nightswimmer/RaspberryPiPicoBase/docs/reference/RPI-RP2350A-MINIMAL_R4-S1_BOM.md

# Reference BOM: RPI-RP2350A-MINIMAL R4-S1

Bill of materials of the Raspberry Pi RP2350A minimal design example (revision R4-S1, July 2026) that this project is based on.
Source: Raspberry Pi Ltd, MIT licence, see NOTICE.md. Kept as a reference for part values and part numbers.

| Item | QTY | Refs | Value | Manufacturer | Manufacturer-PN | RPI-PDB-PN | Description |
|---|---|---|---|---|---|---|---|
| 1 | 3 | C1,C5,C19 | 10u | Murata | GRM21BR61C106KE15L | RP-01GYSK-AVBE41 | Capacitor, MLCC, 10uF, 10%, M2012, 16V, X5R |
| 2 | 11 | C2,C8,C10,C11,C12,C13,C14,C15,C16,C17,C18 | 100n | Murata | GRM155R71E104KE14D | RP-01BJ9Y-KRGF41 | Capacitor, MLCC, 100nF, 10%, M1005, 25V, X7R (10k Reel) |
| 3 | 2 | C3,C4 | 15p | Murata | GRM1555C1H150JA01D | RP-01C89W-LLY9XV | Capacitor, MLCC, 15pF, 5%, M1005, 50V, C0G |
| 4 | 3 | C6,C7,C9 | 4.7u | Murata | GRM155R60J475ME47D | RP-019A1P-0C2GHY | Capacitor, MLCC, 4.7uF, 20%, M1005, 6.3V, X5R (10k Reel) |
| 5 | 1 | J1 | 10103594-0001LF | Amphenol | 10103594-0001LF | RP-019A1P-1JAX7V | Micro-USB B, Socket, RA, PTH/SMT |
| 6 | 2 | J2,J3 | TSW-118-07-L-D | Samtec | TSW-118-07-L-D | RP-01JWH2-G371Y4 | Pin Header, 02x18W, 2.54mm, PTH, Male |
| 7 | 1 | J4 | SM03B-SRSS-TB(LF)(SN) | JST | SM03B-SRSS-TB(LF)(SN) | RP-01EKJ1-8V9SV1 | Header, JST-SH, 01x03W, Pitch=1mm, SMD, Right Angle |
| 8 | 1 | L1 | 3.3u | Abracon | AOTA-B201610S3R3-101-T | RP-01GY5D-2VC7WP | Inductor, SMT, 3.3uH, 20%, Itemp=2.1A, Isat=2.4A, DCR=115mR typ 140mR max, Polarity Marked, M2016 |
| 9 | 1 | R1 | NO-FIT |  | NO-FIT |  |  |
| 10 | 3 | R2,R4,R6 | 1k | Yageo | RC0402FR-071KL | RP-019A1P-4Z6ZWY | Resistor, Chip, 1kR, M1005, 63mW, 1% (10k Reel) |
| 11 | 1 | R3 | 33 | Yageo | RC0402FR-0733RL | RP-019A1P-58PW9L | Resistor, Chip, 33R, M1005, 63mW, 1% (10k Reel) |
| 12 | 2 | R7,R8 | 27 | Yageo | RC0402FR-0727RL | RP-01C89V-LTEYC4 | Resistor, Chip, 27R, M1005, 63mW, 1% (10k Reel) |
| 13 | 1 | R9 | NO-FIT |  | NO-FIT |  |  |
| 14 | 1 | R10 | 0 | Yageo | RC0402JR-070RL | RP-019A1P-4Y4V63 | Resistor, Chip, 0R, M1005, 63mW, +50mR |
| 15 | 2 | SW1,SW2 | 434133025816 | Wurth Elektronik | 434133025816 | RP-01H0MT-6E9H8F | Tactile Pushbutton, SPST, N.O., 4.2x3.2x2.5mm |
| 16 | 1 | U1 | RP2350A | Raspberry Pi | RP2350A | RP-01HA9H-9K5E8T | RP2350A MCU, Dual Cortex M33/Hazard3, QFN-60 |
| 17 | 1 | U2 | NCP1117ST33T3G | ON Semiconductor | NCP1117ST33T3G | RP-01JWD9-7JRX6J | LDO, Vin=4.75-20V, Vout=3.3V, 1A min, SOT-223 |
| 18 | 1 | U3 | W25Q128JVSIQ | Winbond | W25Q128JVSIQ | RP-01JWD4-F1H4N9 | Serial NOR Flash, QSPI, 3V, 128Mbit, SOIC-8 |
| 19 | 1 | X1 | 12MHz | Abracon | ABM8-272-T3 | RP-01G8X7-GS352B | XTAL, SMT, 12 MHz, Fundamental, Ftol=30ppm, Fstab=30ppm, 10pF, 3.2x2.5mm |
