nightswimmer/RaspberryPiPicoBase/bom/bom.csv

Designator | Quantity | Value | Footprint | Manufacturer | Manufacturer Part | LCSC Part # | Description
C1,C5,C19 | 3 | 10u | RaspberryPiPicoBase:generic_capc2012x125 | Samsung Electro-Mechanics | CL21A106KAYNNNE | C15850 | Capacitor, MLCC, 10uF, 10%, M2012, 25V, X5R
C3,C4 | 2 | 33p | RaspberryPiPicoBase:generic_capc1005x50 | FH (Guangdong Fenghua Advanced Tech) | 0402CG330J500NT | C1562 | Capacitor, MLCC, 33pF, 5%, M1005, 50V, C0G
C6,C7 | 2 | 4.7u | RaspberryPiPicoBase:generic_capc1005x50_wide | Samsung Electro-Mechanics | CL05A475MP5NRNC | C23733 | Capacitor, MLCC, 4.7uF, 20%, M1005, 10V, X5R
C8,C10-C18 | 10 | 100n | RaspberryPiPicoBase:generic_capc1005x50 | Samsung Electro-Mechanics | CL05B104KO5NNNC | C1525 | Capacitor, MLCC, 100nF, 10%, M1005, 16V, X7R
C9 | 1 | 4.7u | RaspberryPiPicoBase:generic_capc1005x50 | Samsung Electro-Mechanics | CL05A475MP5NRNC | C23733 | Capacitor, MLCC, 4.7uF, 20%, M1005, 10V, X5R
J1 | 1 | TYPE-C-31-M-12 | RaspberryPiPicoBase:USB_C_Receptacle_HRO_TYPE-C-31-M-12 | Korean Hroparts Elec | TYPE-C-31-M-12 | C165948 | USB-C Receptacle, USB 2.0, 16P, SMD, Right Angle, Korean Hroparts TYPE-C-31-M-12
J2,J3 | 2 | DS1021-2x18SF11-B | RaspberryPiPicoBase:samtec_tsw-118-07-l-d | CONNFLY Elec | DS1021-2x18SF11-B | C7430414 | Pin Header, 02x18W, 2.54mm, PTH, Male
L1 | 1 | 3.3u | RaspberryPiPicoBase:abracon_aota-b201610s3r3-101-t | Abracon | AOTA-B201610S3R3-101-T | C42411119 | Inductor, SMT, 3.3uH, 20%, Irms=2.1A, Isat=2.4A, DCR=115mR typ 140mR max, Polarity Marked, M2016
R2,R4,R6 | 3 | 1k | RaspberryPiPicoBase:generic_resc1005x35 | UNI-ROYAL (Uniroyal Elec) | 0402WGF1001TCE | C11702 | Resistor, Chip, 1kR, M1005, 63mW, 1%
R3 | 1 | 33 | RaspberryPiPicoBase:generic_resc1005x35 | UNI-ROYAL (Uniroyal Elec) | 0402WGF330JTCE | C25105 | Resistor, Chip, 33R, M1005, 63mW, 1%
R7,R8 | 2 | 27 | RaspberryPiPicoBase:generic_resc1005x35 | UNI-ROYAL (Uniroyal Elec) | 0402WGF270JTCE | C25100 | Resistor, Chip, 27R, M1005, 63mW, 1%
R11,R12 | 2 | 5.1k | RaspberryPiPicoBase:generic_resc1005x35 | UNI-ROYAL (Uniroyal Elec) | 0402WGF5101TCE | C25905 | Resistor, Chip, 5.1kR, M1005, 63mW, 1%
SW1,SW2 | 2 | TS-1187A-B-A-B | RaspberryPiPicoBase:xkb_ts-1187a-b-a-b | XKB Connection | TS-1187A-B-A-B | C318884 | Tactile Pushbutton, SPST, N.O., 5.1x5.1x1.5mm, 160gf
U1 | 1 | RP2354A | RaspberryPiPicoBase:rpi_rp2350a_vias | Raspberry Pi | RP2354A | C41378174 | RP2354A MCU, Dual Cortex M33/Hazard3, 2 MB internal flash, QFN-60
U2 | 1 | AMS1117-3.3 | RaspberryPiPicoBase:onsemi_ncp1117st33t3g | Advanced Monolithic Systems | AMS1117-3.3 | C6186 | LDO, Vin=4.75-15V, Vout=3.3V, 1A, SOT-223
X1 | 1 | 12MHz | RaspberryPiPicoBase:generic_xtalcc320x250x80-4 | YXC Crystal Oscillators | X322512MSB4SI | C9002 | XTAL, SMT, 12 MHz, Fundamental, Ftol=10ppm, Fstab=20ppm, 20pF, ESR 80R max, 3.2x2.5mm
