nightswimmer/RaspberryPiPicoBase/RaspberryPiPicoBase.kicad_pcb

## KiCad design RaspberryPiPicoBase.kicad_pcb (2026-11-01)

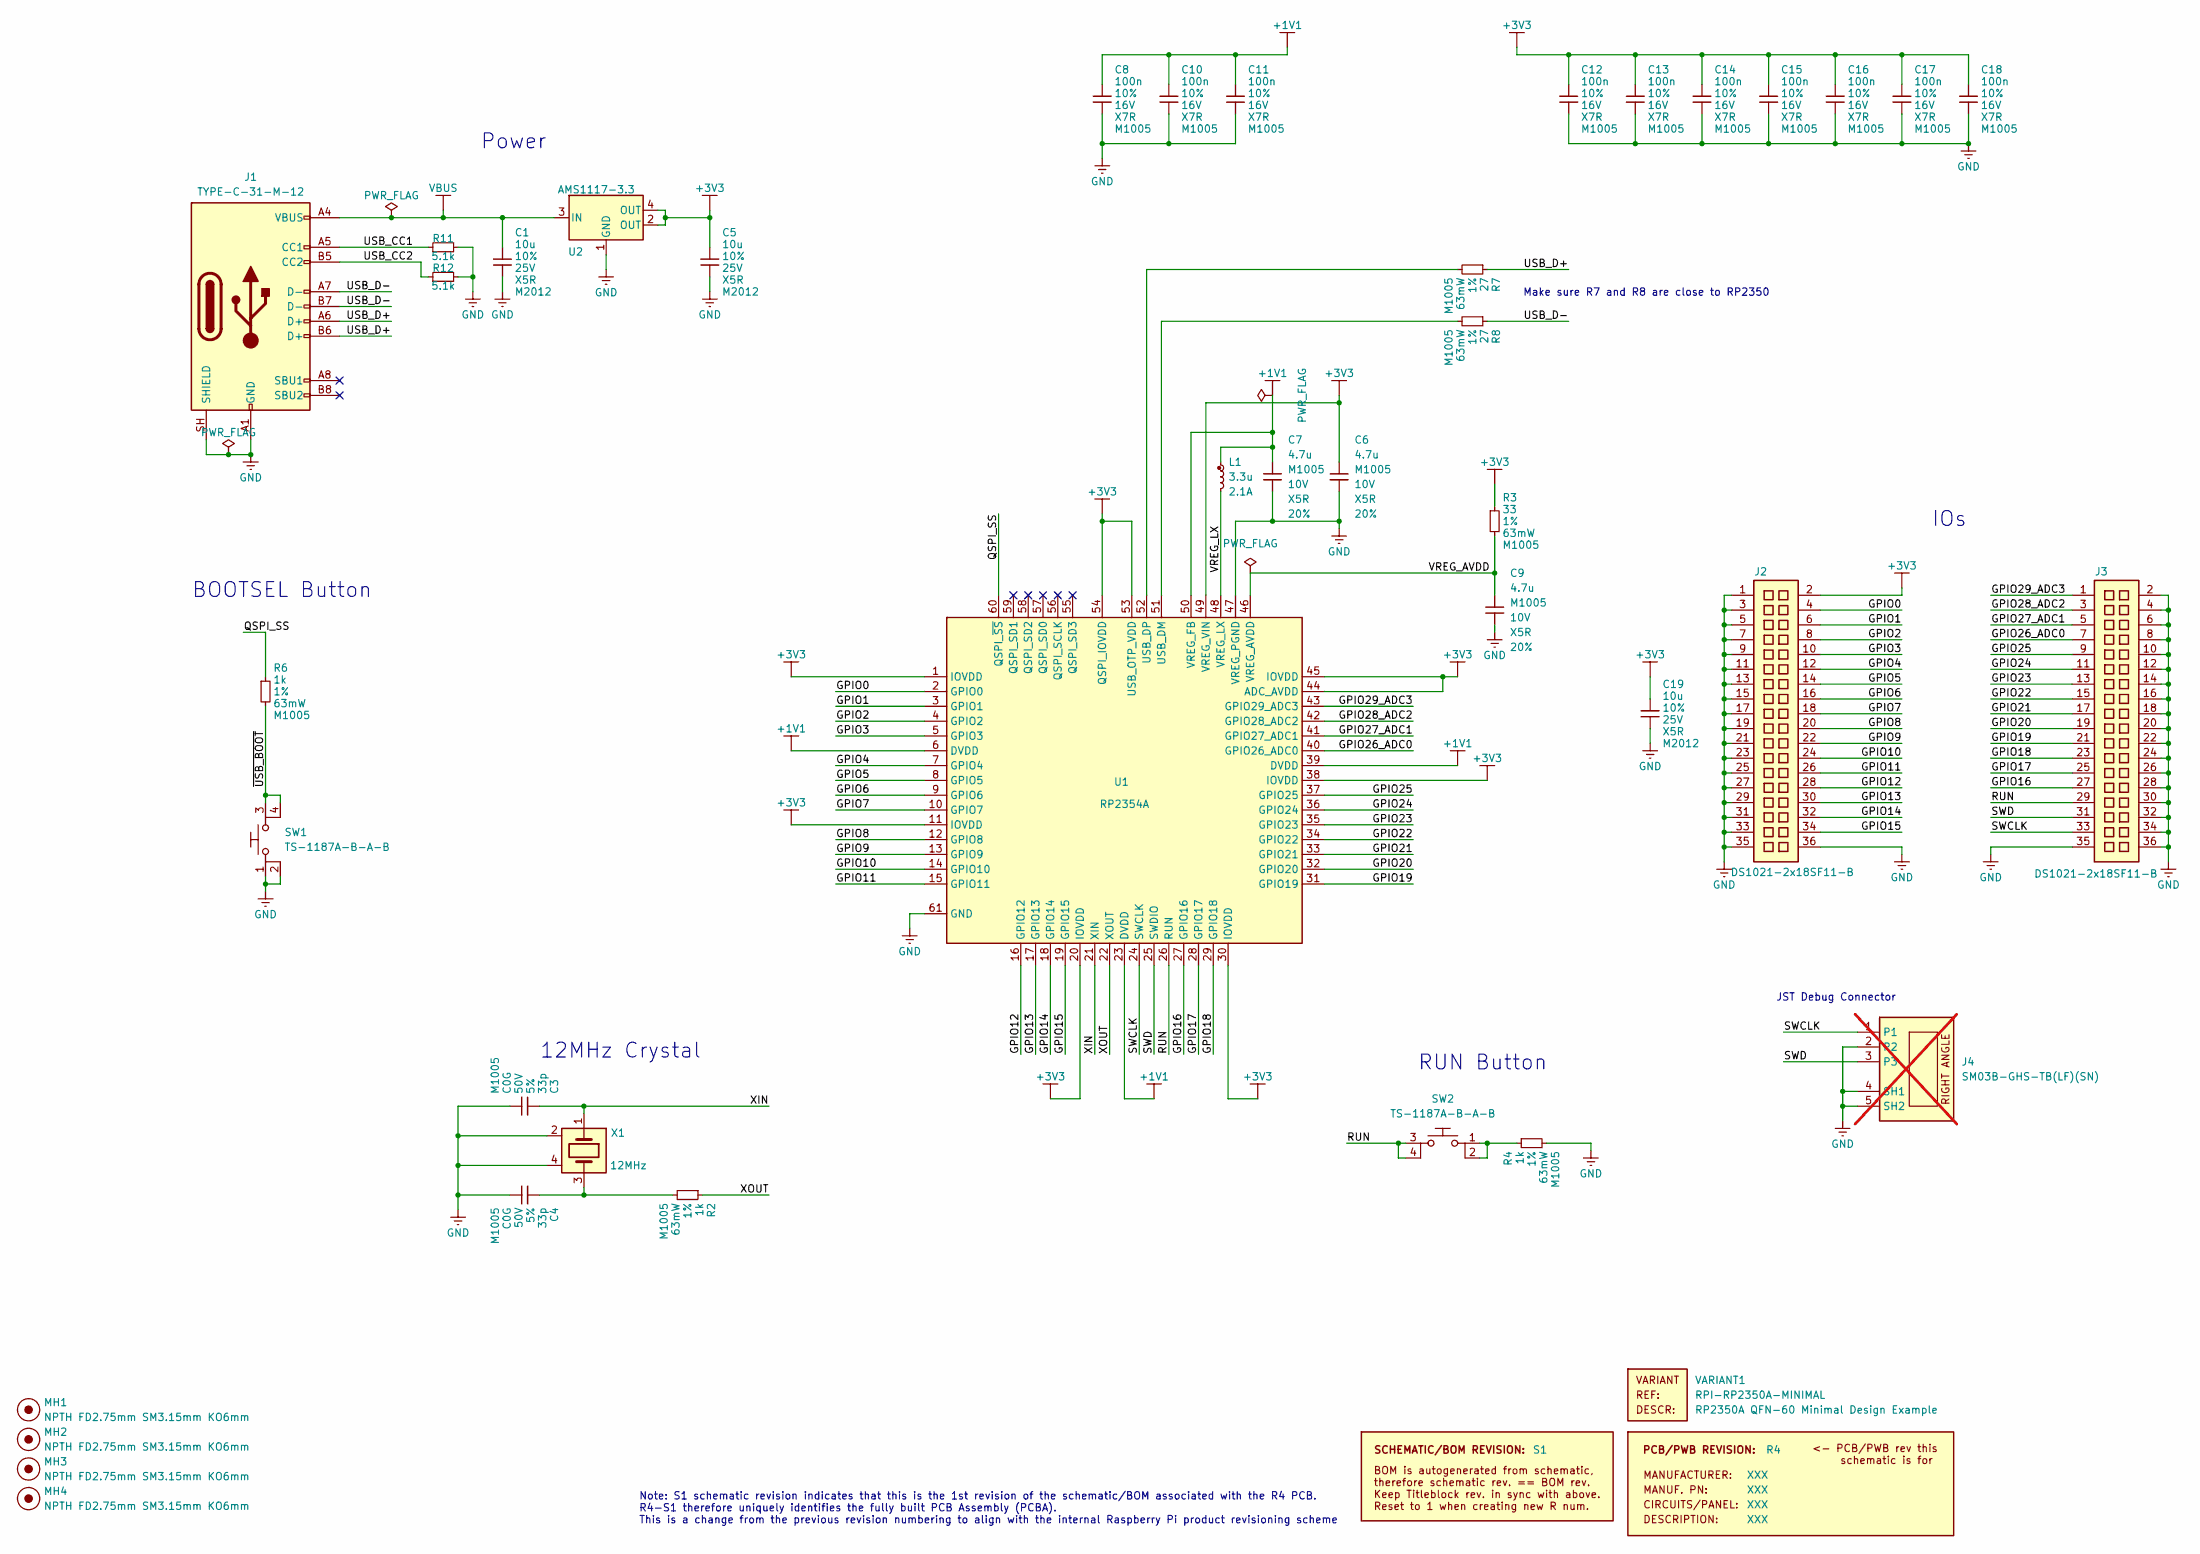
[picture p1: schematic RaspberryPiPicoBase.kicad_sch, Raspberry Pi Pico Base]

Parts:
C1, C5, C19: 10u; generic_capc2012x125; voltage 25V; tolerance 10%; part_uid RP-01GYSK-AVBE41; lcsc_pn C15850
C3, C4: 33p; generic_capc1005x50; voltage 50V; tolerance 5%; part_uid RP-01C89W-LLY9XV; lcsc_pn C1562
C6, C7: 4.7u; generic_capc1005x50_wide; voltage 10V; tolerance 20%; part_uid RP-019A1P-0C2GHY; lcsc_pn C23733
C8, C10, C11, C12, C13, C14, C15, C16, C17, C18: 100n; generic_capc1005x50; voltage 16V; tolerance 10%; part_uid RP-01BJ9Y-KRGF41; lcsc_pn C1525
C9: 4.7u; generic_capc1005x50; voltage 10V; tolerance 20%; part_uid RP-019A1P-0C2GHY; lcsc_pn C23733
J1: TYPE-C-31-M-12; USB_C_Receptacle_HRO_TYPE-C-31-M-12; manufacturer_pn TYPE-C-31-M-12; lcsc_pn C165948
J2, J3: DS1021-2x18SF11-B; samtec_tsw-118-07-l-d; part_uid RP-01JWH2-G371Y4; lcsc_pn C7430414
J4: SM03B-GHS-TB(LF)(SN); jst_sm03b-ghs-tb; part_uid RP-01EKJ1-8V9SV1; lcsc_pn C514175; not fitted
L1: 3.3u; abracon_aota-b201610s3r3-101-t; tolerance 20%; part_uid RP-01GY5D-2VC7WP; lcsc_pn C42411119
MH1, MH2, MH3, MH4: NPTH FD2.75mm SM3.15mm KO6mm; none_mh_npth_fd2p75mm_sm3p15mm_ko6mm; part_uid RP-01HF5R-LCTEJS
PCB1: R4; manufacturer_pn XXX
R2, R4, R6: 1k; generic_resc1005x35; tolerance 1%; voltage 50V; part_uid RP-019A1P-4Z6ZWY; lcsc_pn C11702
R3: 33; generic_resc1005x35; tolerance 1%; voltage 50V; part_uid RP-019A1P-58PW9L; lcsc_pn C25105
R7, R8: 27; generic_resc1005x35; tolerance 1%; voltage 50V; part_uid RP-01C89V-LTEYC4; lcsc_pn C25100
R11, R12: 5.1k; generic_resc1005x35; tolerance 1%; manufacturer_pn 0402WGF5101TCE; lcsc_pn C25905
SBREV1: S1
SW1, SW2: TS-1187A-B-A-B; xkb_ts-1187a-b-a-b; part_uid RP-01H0MT-6E9H8F; lcsc_pn C318884
U1: RP2354A; rpi_rp2350a_vias; part_uid RP-01HA9H-9K5E8T; lcsc_pn C41378174
U2: AMS1117-3.3; onsemi_ncp1117st33t3g; voltage 3.3V; part_uid RP-01JWD9-7JRX6J; lcsc_pn C6186
VARIANT1: RPI-RP2350A-MINIMAL
X1: 12MHz; generic_xtalcc320x250x80-4; tolerance 10ppm; part_uid RP-01G8X7-GS352B; lcsc_pn C9002

Connections:
+1V1: C7.1, C8.1, C10.1, C11.1, L1.1, U1.6 (DVDD), U1.23 (DVDD), U1.39 (DVDD), U1.50 (VREG_FB)
+3V3: C5.1, C6.1, C12.1, C13.1, C14.1, C15.1, C16.1, C17.1, C18.1, C19.1, J2.2, R3.1, U1.1 (IOVDD), U1.11 (IOVDD), U1.20 (IOVDD), U1.30 (IOVDD), U1.38 (IOVDD), U1.44 (ADC_AVDD), U1.45 (IOVDD), U1.49 (VREG_VIN), U1.53 (USB_OTP_VDD), U1.54 (QSPI_IOVDD), U2.2 (OUT), U2.4 (OUT)
/GPIO0: J2.4, U1.2 (GPIO0)
/GPIO1: J2.6, U1.3 (GPIO1)
/GPIO2: J2.8, U1.4 (GPIO2)
/GPIO3: J2.10, U1.5 (GPIO3)
/GPIO4: J2.12, U1.7 (GPIO4)
/GPIO5: J2.14, U1.8 (GPIO5)
/GPIO6: J2.16, U1.9 (GPIO6)
/GPIO7: J2.18, U1.10 (GPIO7)
/GPIO8: J2.20, U1.12 (GPIO8)
/GPIO9: J2.22, U1.13 (GPIO9)
/GPIO10: J2.24, U1.14 (GPIO10)
/GPIO11: J2.26, U1.15 (GPIO11)
/GPIO12: J2.28, U1.16 (GPIO12)
/GPIO13: J2.30, U1.17 (GPIO13)
/GPIO14: J2.32, U1.18 (GPIO14)
/GPIO15: J2.34, U1.19 (GPIO15)
/GPIO16: J3.27, U1.27 (GPIO16)
/GPIO17: J3.25, U1.28 (GPIO17)
/GPIO18: J3.23, U1.29 (GPIO18)
/GPIO19: J3.21, U1.31 (GPIO19)
/GPIO20: J3.19, U1.32 (GPIO20)
/GPIO21: J3.17, U1.33 (GPIO21)
/GPIO22: J3.15, U1.34 (GPIO22)
/GPIO23: J3.13, U1.35 (GPIO23)
/GPIO24: J3.11, U1.36 (GPIO24)
/GPIO25: J3.9, U1.37 (GPIO25)
/GPIO26_ADC0: J3.7, U1.40 (GPIO26_ADC0)
/GPIO27_ADC1: J3.5, U1.41 (GPIO27_ADC1)
/GPIO28_ADC2: J3.3, U1.42 (GPIO28_ADC2)
/GPIO29_ADC3: J3.1, U1.43 (GPIO29_ADC3)
/QSPI_SS: R6.1, U1.60 (QSPI_~SS)
/RUN: J3.29, SW2.3, SW2.4, U1.26 (RUN)
/SWCLK: J3.33, J4.1, U1.24 (SWCLK)
/SWD: J3.31, J4.3, U1.25 (SWDIO)
/USB_CC1: J1.A5 (CC1), R11.1
/USB_CC2: J1.B5 (CC2), R12.1
/USB_D+: J1.A6 (D+), J1.B6 (D+), R7.1
/USB_D-: J1.A7 (D-), J1.B7 (D-), R8.1
/VREG_AVDD: C9.1, R3.2, U1.46 (VREG_AVDD)
/VREG_LX: L1.2, U1.48 (VREG_LX)
/XIN: C3.1, U1.21 (XIN), X1.1
/XOUT: R2.1, U1.22 (XOUT)
/~USB_BOOT: R6.2, SW1.3, SW1.4
GND: C1.2, C3.2, C4.2, C5.2, C6.2, C7.2, C8.2, C9.2, C10.2, C11.2, C12.2, C13.2, C14.2, C15.2, C16.2, C17.2, C18.2, C19.2, J1.A1 (GND), J1.A12 (GND), J1.B1 (GND), J1.B12 (GND), J1.SH (SHIELD), J2.1, J2.3, J2.5, J2.7, J2.9, J2.11, J2.13, J2.15, J2.17, J2.19, J2.21, J2.23, J2.25, J2.27, J2.29, J2.31, J2.33, J2.35, J2.36, J3.2, J3.4, J3.6, J3.8, J3.10, J3.12, J3.14, J3.16, J3.18, J3.20, J3.22, J3.24, J3.26, J3.28, J3.30, J3.32, J3.34, J3.35, J3.36, J4.2, J4.4 (SH1), J4.5 (SH2), R4.2, R11.2, R12.2, SW1.1, SW1.2, U1.47 (VREG_PGND), U1.61 (GND), U2.1 (GND), X1.2, X1.4
unnamed: C4.1, R2.2, X1.3
unnamed: R4.1, SW2.1, SW2.2
unnamed: R8.2, U1.51 (USB_DM)
unnamed: R7.2, U1.52 (USB_DP)
VBUS: C1.1, J1.A4 (VBUS), J1.A9 (VBUS), J1.B4 (VBUS), J1.B9 (VBUS), U2.3 (IN)

Notes on the sheet:
JST Debug Connector
IOs
RUN Button
BOOTSEL Button
Note: S1 schematic revision indicates that this is the 1st revision of the schematic/BOM associated with the R4 PCB. R4-S1 therefore uniquely identifies the fully built PCB Assembly (PCBA). This is a change from the previous revision numbering to align with the internal Raspberry Pi product revisio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
Make sure R7 and R8 are close to RP2350
12MHz Crystal
Power

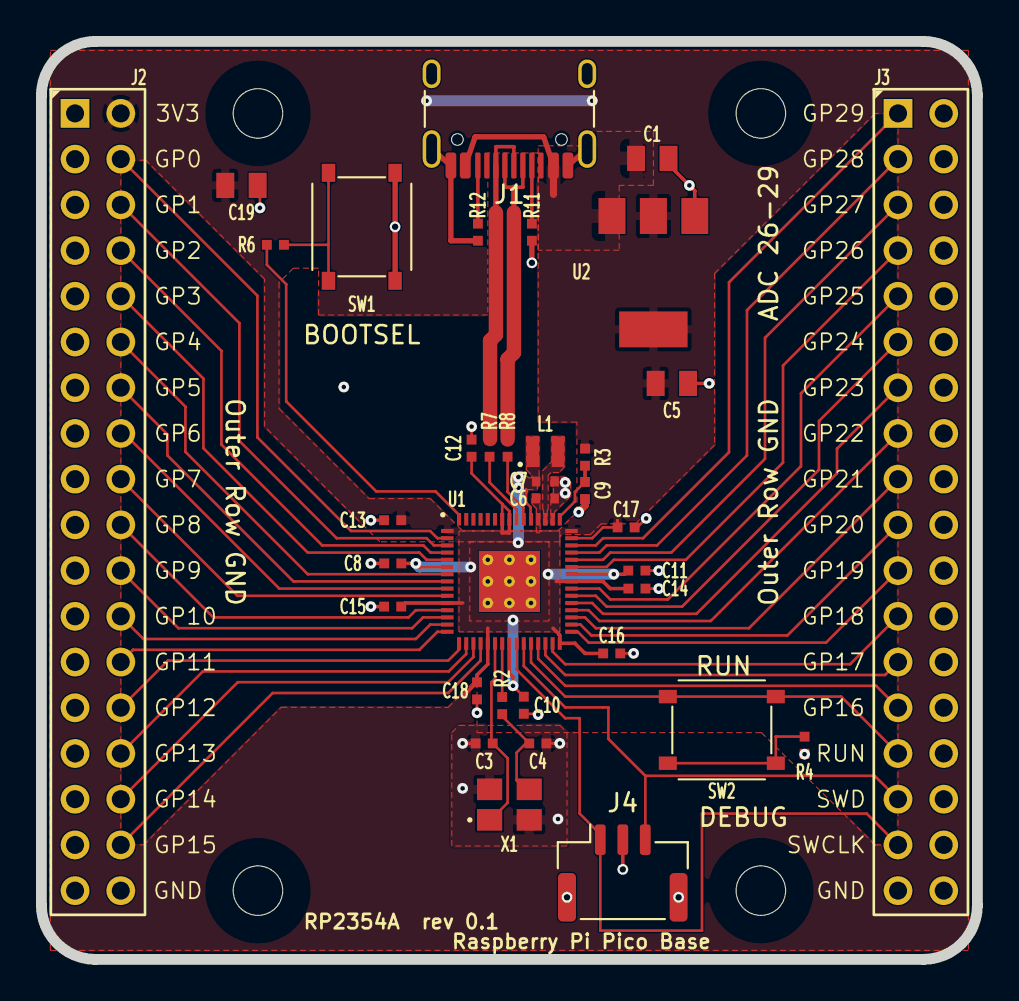
[picture p2: board RaspberryPiPicoBase.kicad_pcb from above]

Board: 2 copper layers, 52.0 x 51.0 mm, 40 parts (0 on the bottom side), 51 nets.
