nightswimmer/RaspberryPiPicoBase/(commit log)

2026-11-01 Set up RP2350A base project and KiCad MCP
    Import the Raspberry Pi RP2350A minimal design (R4-S1, MIT) as the base
    board, make it self-contained with project-local symbol/footprint
    libraries and embedded 3D models, and clean ERC/DRC to zero. Add
    kicad-mcp-pro configuration for Claude Code, attribution notice,
    reference docs and project instructions.
2026-11-01 Target RP2354A and remove external flash
    Switch U1 to the RP2354A (in-package flash), delete the external QSPI
    flash circuit from schematic and board, add no-connects on the unused
    QSPI pins, keep QSPI_SS wired to BOOTSEL, refill zones and update the
    silkscreen title.
    [RaspberryPiPicoBase.kicad_pcb, RaspberryPiPicoBase.kicad_sch]
2026-11-01 Switch to USB-C and organise the BOM for JLCPCB
    Replace the Micro-USB connector with a USB-C receptacle (HRO TYPE-C-31-M-12)
    with CC pull-downs, reroute USB, and add LCSC part numbers to every part.
    Swap to JLCPCB Basic parts where a drop-in exists: Samsung/Fenghua MLCCs,
    Uniroyal resistors, AMS1117-3.3, YXC 12 MHz crystal (33 pF load caps) and
    XKB TS-1187A switches with a new footprint and re-placed SW1/SW2. Change the
    debug connector to JST GH and mark it DNP (SWD remains on J3). Embed 3D
    models for the new parts, add docs/BOM.md with sourcing status and the
    generated bom/bom.csv and bom/cpl.csv.
    [RaspberryPiPicoBase.kicad_pcb, RaspberryPiPicoBase.kicad_sch, bom.csv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]
